arianaDaboc/NavCore/backup-version/firmware/navcore_wifi/app_gz.h

// generat automat din navcore_simulator.html - nu edita
#pragma once
#include <stdint.h>
#include <stddef.h>
const size_t APP_GZ_LEN = 30680;
const uint8_t APP_GZ[] PROGMEM = {
0x1f,0x8b,0x08,0x00,0x00,0x00,0x00,0x00,0x02,0xff,0xcc,0xbd,0x4b,0x73,0x1b,0x49,0x92,0x27,0x7e,0xd7,
0xa7,0x48,0x71,0xa6,0x1b,0x40,0x89,0x00,0x01,0xf0,0x21,0x0a,0x14,0xa9,0xe5,0xb3,0x4a,0xd3,0xd4,0xc3,
0x48,0x56,0x97,0x6a,0xd4,0x9a,0xb6,0x24,0x90,0x24,0xb3,0x04,0x20,0x51,0x99,0x00,0x49,0x54,0x95,0xcc,
0xc6,0xac,0xcd,0xd6,0x76,0x2f,0x7b,0x98,0x5d,0xb3,0xd9,0xb1,0xb9,0xcd,0xe1,0x7f,0x5c,0xdb,0xdb,0xde,
0xa7,0xfb,0xd0,0x9f,0xa3,0x3f,0xc9,0xff,0xe7,0xee,0xf1,0xcc,0x07,0x48,0xaa,0xaa,0x67,0xb7,0x67,0x4a,
0x44,0x46,0x46,0xc6,0xc3,0xc3,0xc3,0xdd,0xc3,0x5f,0xf1,0xfc,0xf1,0x20,0xe9,0x4f,0xe7,0x93,0x28,0xb8,
0x9a,0x8e,0x86,0x3b,0x8f,0x9e,0xd3,0x9f,0x60,0x18,0x8e,0x2f,0xb7,0x97,0xd2,0x64,0x89,0x0a,0xa2,0x70,
0x80,0x3f,0xa3,0x68,0x1a,0x06,0xfd,0xab,0x30,0xcd,0xa2,0xe9,0xf6,0xd2,0x6c,0x7a,0xd1,0xdc,0x5c,0xd2,
0xc5,0xe3,0x70,0x14,0x6d,0x2f,0x5d,0xc7,0xd1,0xcd,0x24,0x49,0xa7,0x4b,0x41,0x3f,0x19,0x4f,0xa3,0x31,
0xaa,0xdd,0xc4,0x83,0xe9,0xd5,0xf6,0x20,0xba,0x8e,0xfb,0x51,0x93,0x1f,0x96,0x83,0x78,0x1c,0x4f,0xe3,
0x70,0xd8,0xcc,0xfa,0xe1,0x30,0xda,0xee,0x2c,0x07,0xfa,0xbb,0xe6,0x45,0x3c,0xdd,0xee,0x27,0xd7,0x51,
0x4a,0x0d,0x4f,0xe3,0xe9,0x30,0xda,0x39,0x8d,0x47,0xb3,0x61,0x38,0x4d,0xd2,0xe0,0x75,0x78,0xbd,0x9f,
0xa4,0xd1,0xf3,0x15,0x79,0xf1,0xe8,0xf9,0x30,0x1e,0x7f,0x0c,0xd2,0x68,0xb8,0xbd,0x34,0x49,0x23,0xf4,
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
0xfa,0x4c,0xd2,0x38,0x63,0x64,0xd9,0x58,0x5d,0xdd,0xd8,0x77,0x0b,0xb1,0xe1,0x79,0x55,0x8e,0x9e,0xee,
0x3f,0xd3,0xe8,0x92,0x5d,0x85,0x83,0xe4,0xa6,0x17,0xb4,0x83,0xce,0xe4,0x36,0xe8,0xe2,0x3f,0x06,0x57,
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
};
