arianaDaboc/NavCore/latest-version/firmware/navcore_wifi/app_gz.h

// generat automat din navcore_simulator.html - nu edita
#pragma once
#include <stdint.h>
#include <stddef.h>
const size_t APP_GZ_LEN = 30178;
const uint8_t APP_GZ[] PROGMEM = {
0x1f,0x8b,0x08,0x00,0x00,0x00,0x00,0x00,0x02,0xff,0xcc,0xbd,0xd9,0x76,0x1b,0x49,0x92,0x26,0x7c,0xaf,
0xa7,0x08,0xb1,0xbb,0x0a,0x40,0x8a,0x00,0x01,0x70,0x11,0x05,0x88,0xd4,0x70,0x2d,0x69,0x8a,0x5a,0x0e,
0xc9,0xac,0x94,0x46,0xad,0xae,0x83,0x25,0x48,0x22,0x09,0x20,0x20,0x04,0xb8,0xa0,0x33,0x75,0x4e,0x5f,
0xcd,0x99,0xff,0xb6,0xff,0x39,0x67,0xde,0xe0,0xbf,0x9e,0xbb,0xb9,0xef,0x79,0x93,0x7a,0x92,0xff,0x33,
0x33,0xdf,0x23,0x02,0x04,0x95,0x59,0x3d,0x53,0xdd,0x29,0x22,0x3c,0x3c,0x7c,0x31,0x37,0x33,0xb7,0xcd,
0xcd,0x5f,0x3e,0xed,0x27,0xbd,0xd9,0x7c,0x12,0x47,0x57,0xb3,0xd1,0x70,0xf7,0xc9,0x4b,0xfa,0x13,0x0d,
0x3b,0xe3,0xcb,0x9d,0x95,0x78,0xbc,0x42,0x05,0x71,0xa7,0x8f,0x3f,0xa3,0x78,0xd6,0x89,0x7a,0x57,0x9d,
0x69,0x1a,0xcf,0x76,0x56,0x6e,0x66,0x17,0xd5,0xed,0x15,0x5d,0x3c,0xee,0x8c,0xe2,0x9d,0x95,0xdb,0x41,
0x7c,0x37,0x49,0xa6,0xb3,0x95,0xa8,0x97,0x8c,0x67,0xf1,0x18,0xd5,0xee,0x06,0xfd,0xd9,0xd5,0x4e,0x3f,
0xbe,0x1d,0xf4,0xe2,0x2a,0x3f,0xac,0x46,0x83,0xf1,0x60,0x36,0xe8,0x0c,0xab,0x69,0xaf,0x33,0x8c,0x77,
0x1a,0xab,0x91,0xfe,0xae,0x7a,0x31,0x98,0xed,0xf4,0x92,0xdb,0x78,0x4a,0x0d,0xcf,0x06,0xb3,0x61,0xbc,
0xfb,0xae,0x73,0x7b,0x90,0x4c,0xe3,0xe8,0x6c,0x30,0xba,0x19,0x76,0x66,0xc9,0xf4,0xe5,0x9a,0xbc,0x78,
0xf2,0x72,0x38,0x18,0x5f,0x47,0xd3,0x78,0xb8,0xb3,0x32,0x99,0xc6,0xe8,0x71,0x1c,0xf7,0xd0,0xf5,0xd5,
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
0x33,0x99,0x0e,0x52,0x46,0x96,0xad,0xf5,0xf5,0xad,0x03,0xb7,0x10,0x04,0xcf,0xab,0x72,0xfc,0xfc,0xe0,
0x85,0x46,0x97,0xf4,0xaa,0xd3,0x4f,0xee,0x5a,0x51,0x3d,0x6a,0x4c,0xee,0xa3,0x26,0xfe,0x63,0x70,0x35,
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
};
